GHF/grits/Grits 1.2a.pdf

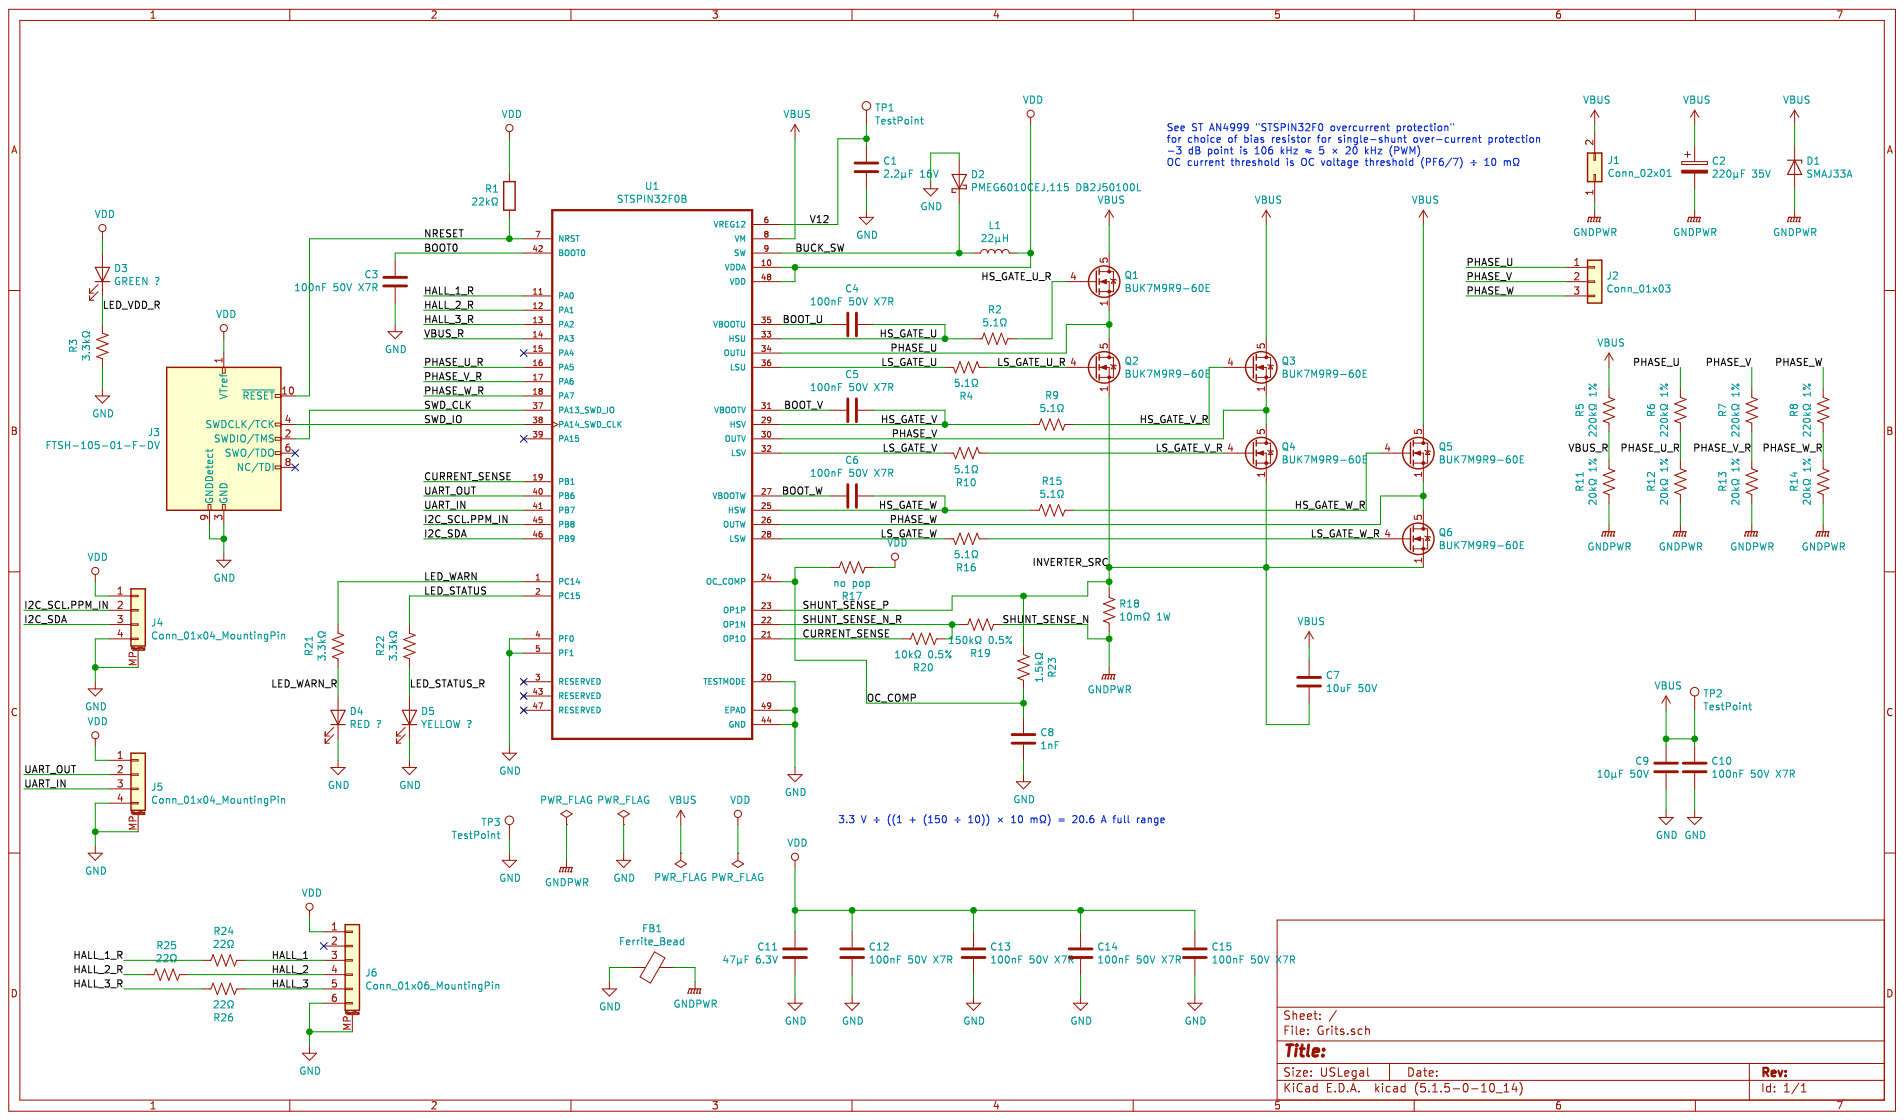
[picture p1: page 1]
