GHF/grits/Grits 1.2b.pdf

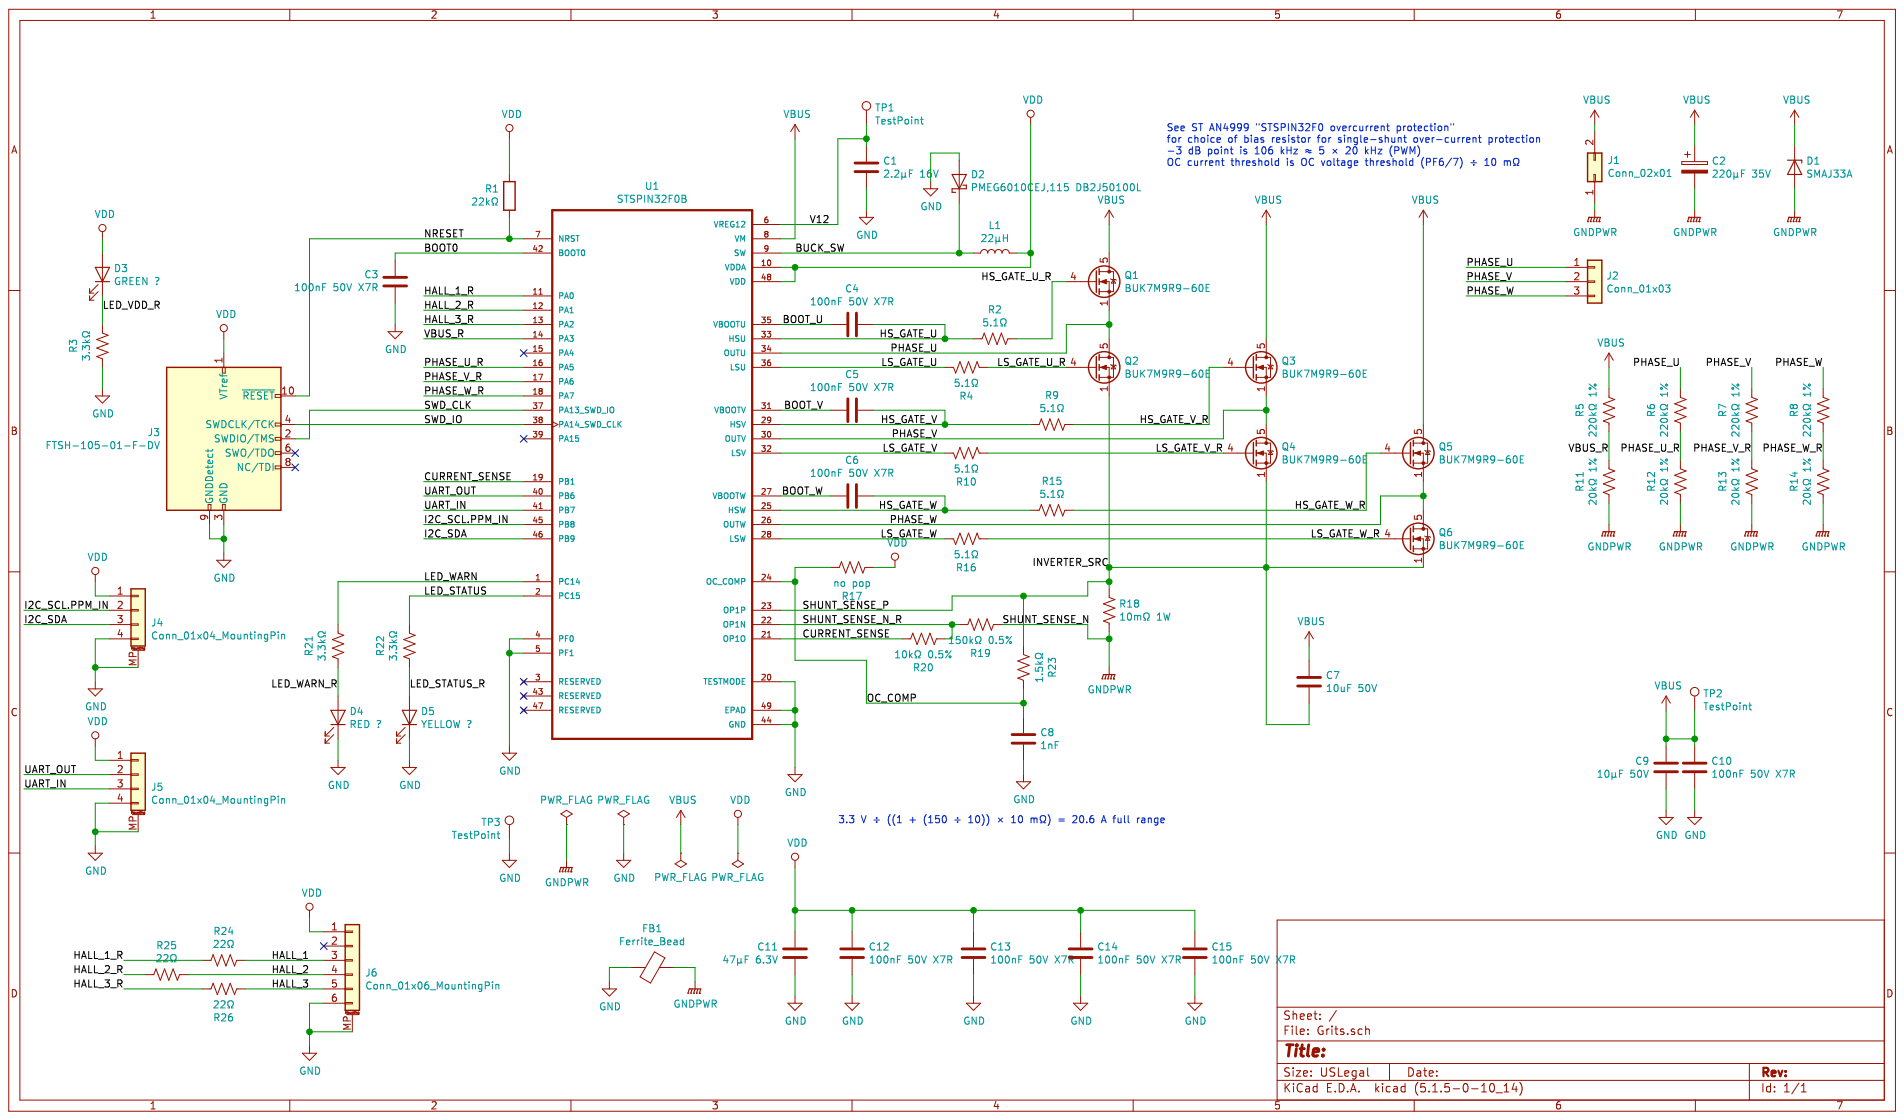
[picture p2: page 1]
