GHF/grits/Grits v1.3a.pdf

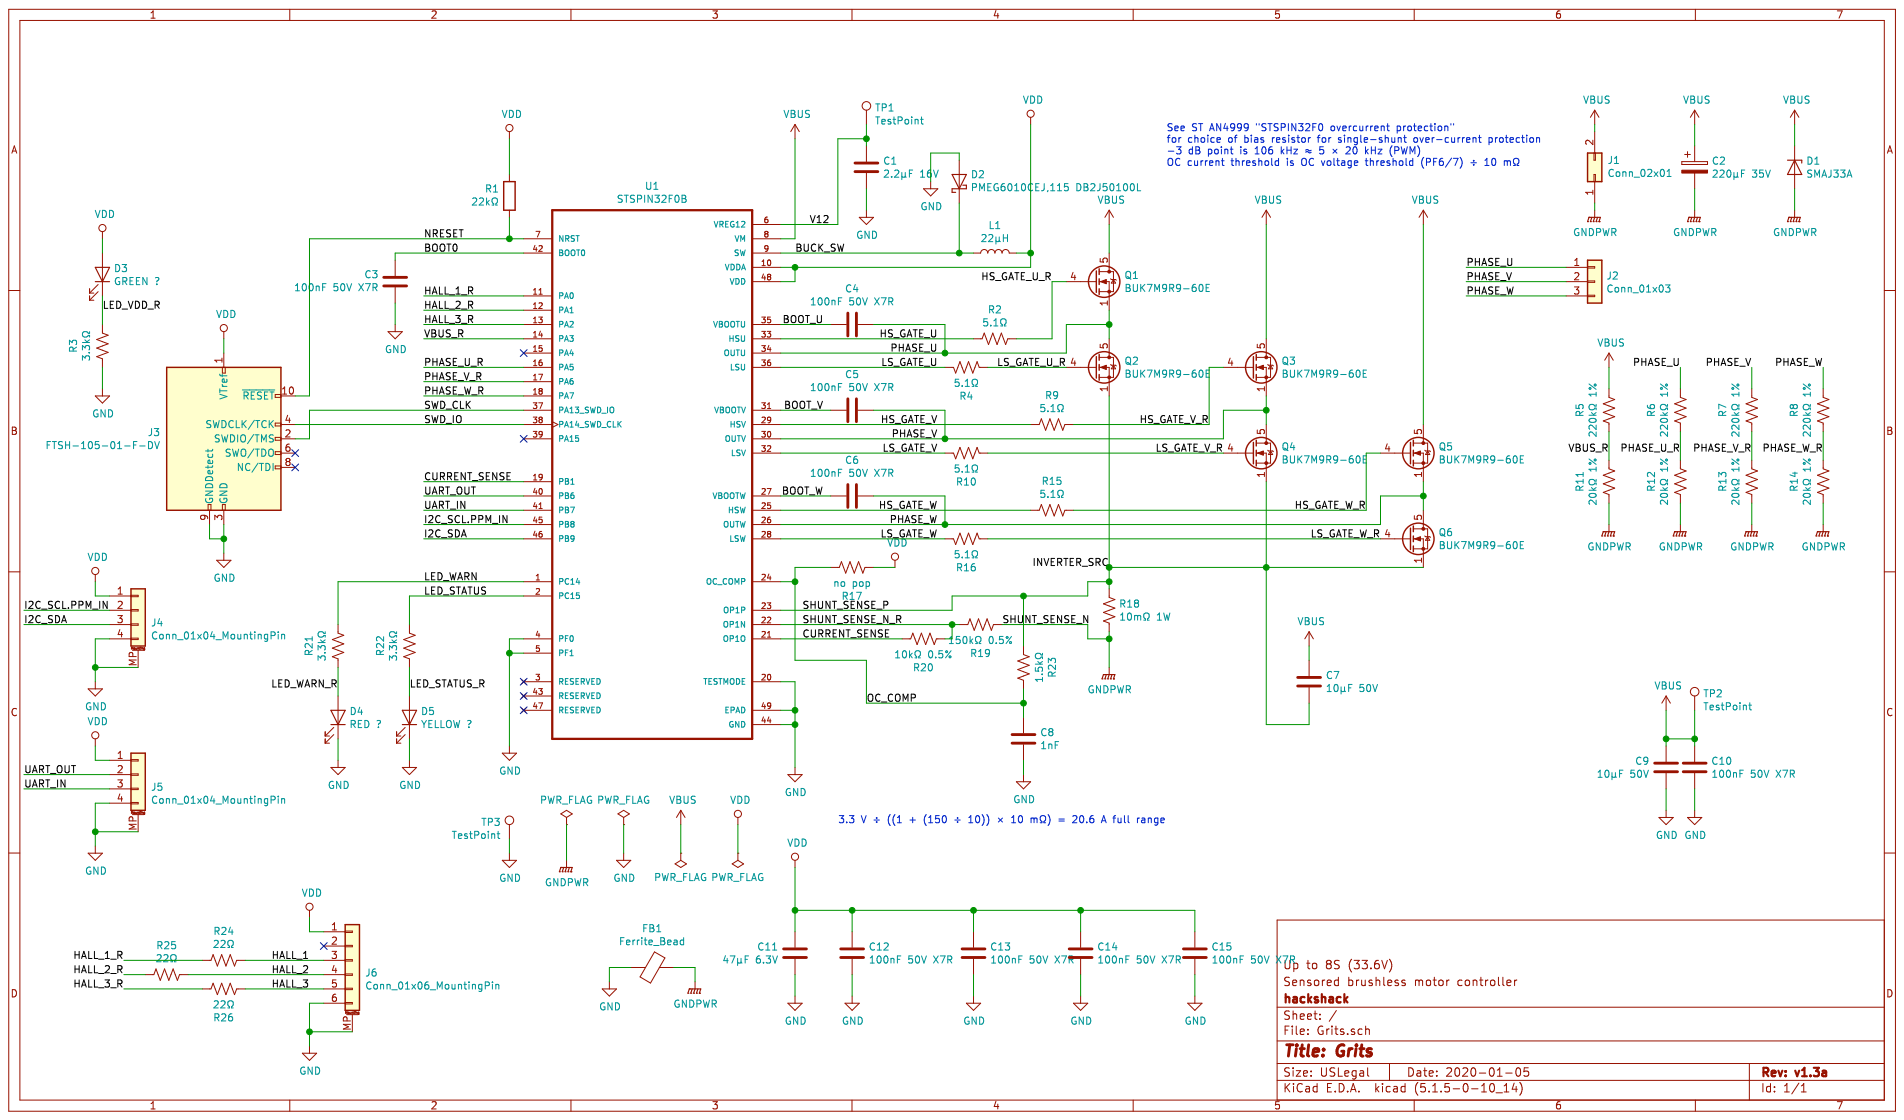
[picture p3: page 1]
