GHF/grits/Grits.kicad_pcb

## KiCad design Grits.kicad_pcb (2020-01-05)

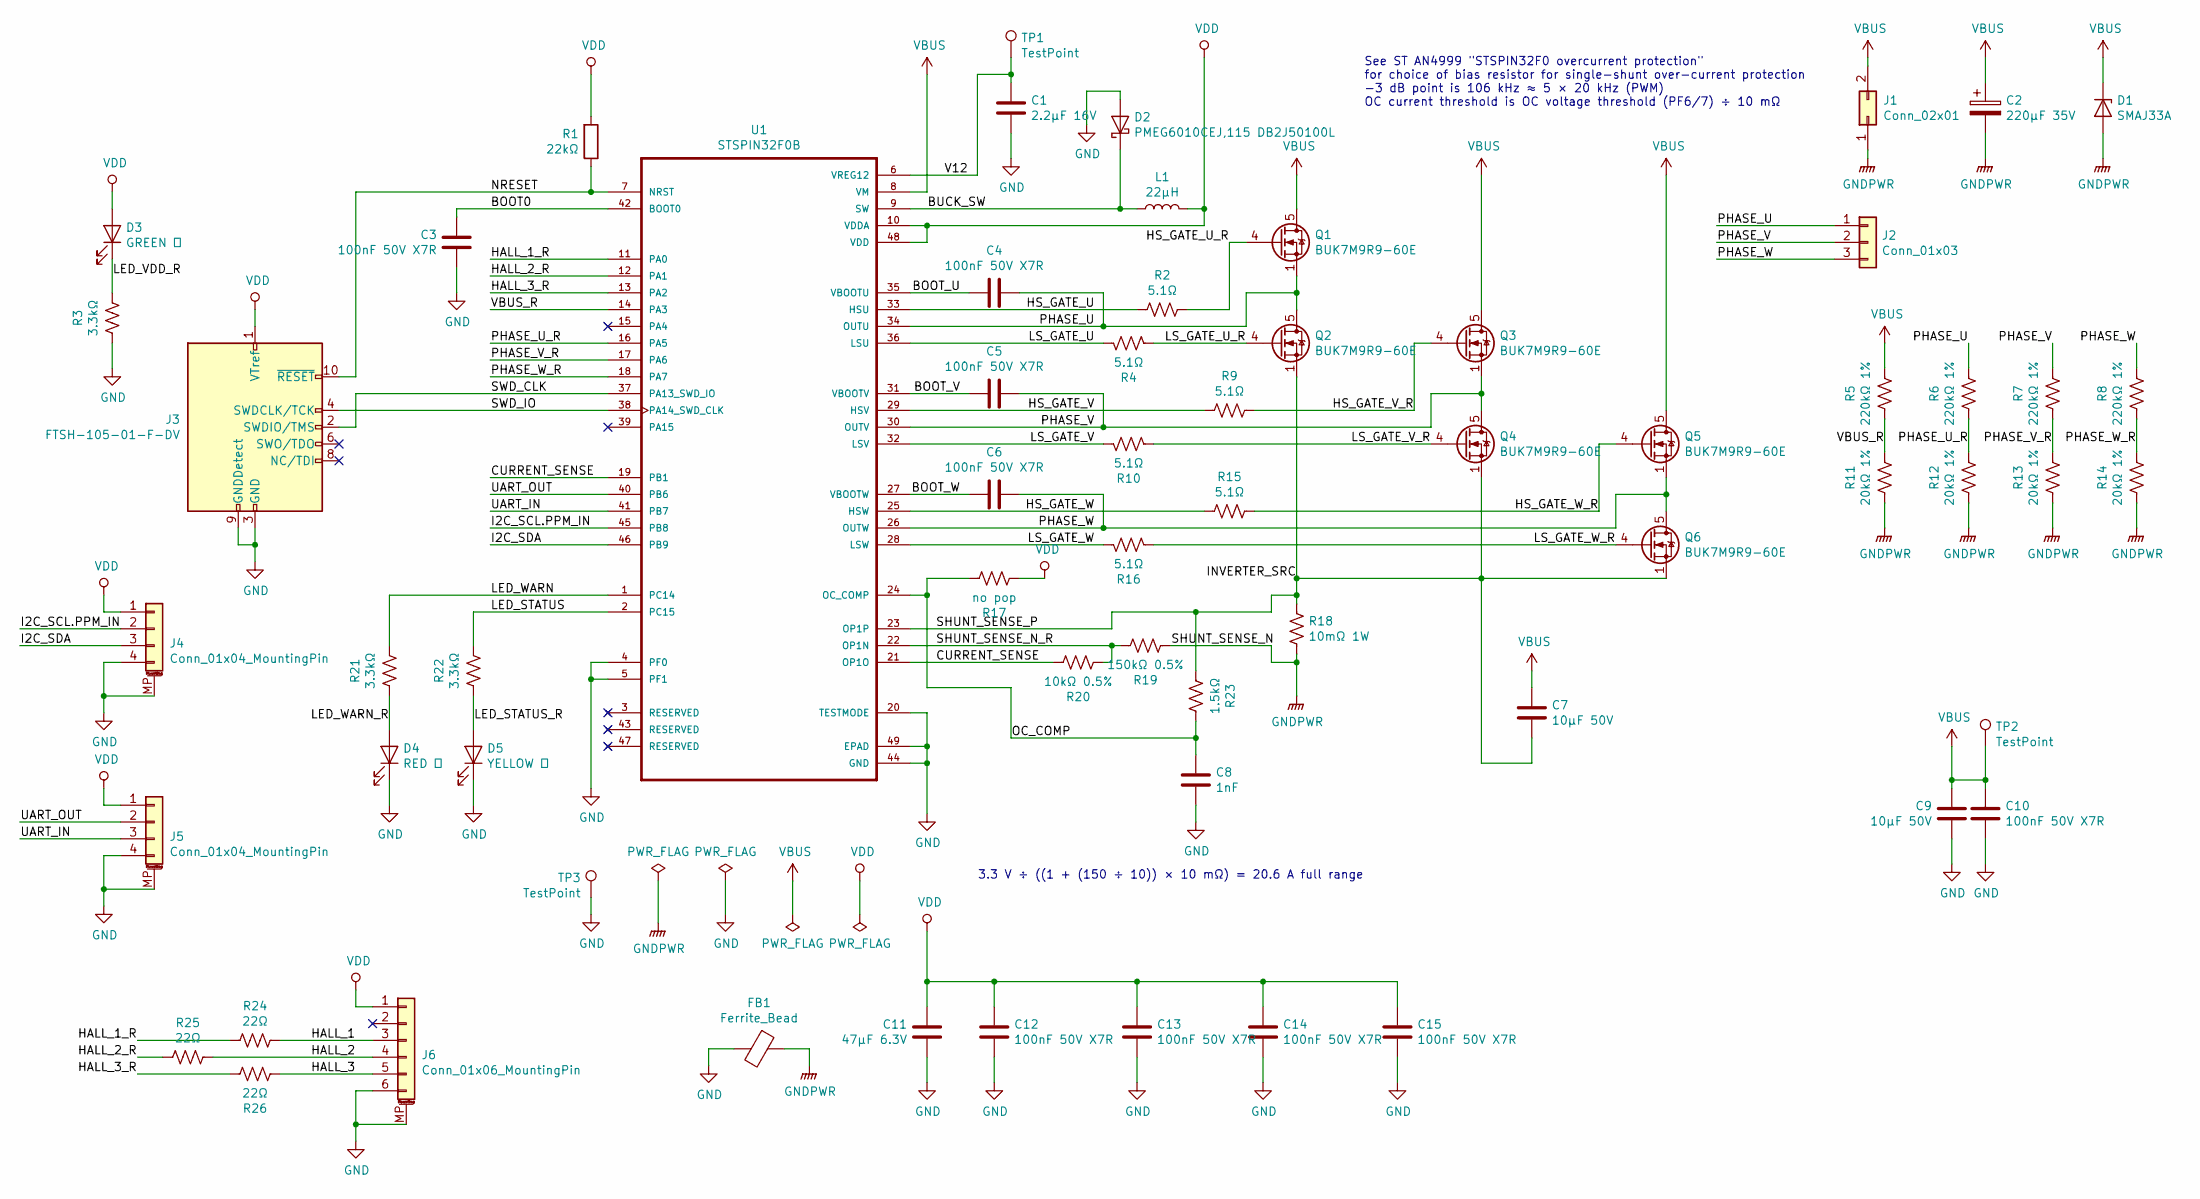
[picture p4: schematic Grits.sch]

Parts:
C1: 2.2µF 16V; C_0603_1608Metric
C2: 220µF 35V; CP_Elec_8x10.5
C3, C4, C5, C6, C10, C12, C13, C14, C15: 100nF 50V X7R; C_0603_1608Metric
C7, C9: 10µF 50V; C_1206_3216Metric
C8: 1nF; C_0603_1608Metric
C11: 47µF 6.3V; C_0805_2012Metric
D1: SMAJ33A; D_SMA
D2: PMEG6010CEJ,115 DB2J50100L; D_SOD-323F
D3: GREEN 绿; LED_0805_2012Metric
D4: RED 红; LED_0805_2012Metric
D5: YELLOW 黄; LED_0805_2012Metric
FB1: Ferrite_Bead; L_0603_1608Metric
J1: Conn_02x01; Molex_Micro-Fit_3.0_43045-0200_2x01_P3.00mm_Horizontal
J2: Conn_01x03; Molex_Micro-Fit_3.0_43650-0300_1x03_P3.00mm_Horizontal
J3: FTSH-105-01-F-DV; PinHeader_2x05_P1.27mm_Vertical_SMD
J4, J5: Conn_01x04_MountingPin; JST_GH_SM04B-GHS-TB_1x04-1MP_P1.25mm_Horizontal
J6: Conn_01x06_MountingPin; JST_GH_BM06B-GHS-TBT_1x06-1MP_P1.25mm_Vertical
L1: 22µH; L_1008_2520Metric
Q1, Q2, Q3, Q4, Q5, Q6: BUK7M9R9-60E; LFPAK33
R1: 22kΩ; R_0603_1608Metric
R2, R4, R9, R10, R15, R16: 5.1Ω; R_0603_1608Metric
R3, R21, R22: 3.3kΩ; R_0603_1608Metric
R5, R6, R7, R8: 220kΩ 1%; R_0603_1608Metric
R11, R12, R13, R14: 20kΩ 1%; R_0603_1608Metric
R17: no pop; R_0603_1608Metric
R18: 10mΩ 1W; R_1206_3216Metric
R19: 150kΩ 0.5%; R_0603_1608Metric
R20: 10kΩ 0.5%; R_0603_1608Metric
R23: 1.5kΩ; R_0603_1608Metric
R24, R25, R26: 22Ω; R_0603_1608Metric
TP1, TP2, TP3: TestPoint; TestPoint_Pad_D1.0mm
U1: STSPIN32F0B; VQFN-48-1EP_7x7mm_P0.5mm_EP2.8x2.8mm

Connections:
/BOOT0: C3.2, U1.42 (BOOT0)
/BOOT_U: C4.2, U1.35 (VBOOTU)
/BOOT_V: C5.2, U1.31 (VBOOTV)
/BOOT_W: C6.2, U1.27 (VBOOTW)
/BUCK_SW: D2.1 (K), L1.1, U1.9 (SW)
/CURRENT_SENSE: R20.1, U1.19 (PB1), U1.21 (OP1O)
/HALL_1: J6.3, R24.1
/HALL_1_R: R24.2, U1.11 (PA0)
/HALL_2: J6.4, R25.1
/HALL_2_R: R25.2, U1.12 (PA1)
/HALL_3: J6.5, R26.2
/HALL_3_R: R26.1, U1.13 (PA2)
/HS_GATE_U: R2.2, U1.33 (HSU)
/HS_GATE_U_R: Q1.4 (G), R2.1
/HS_GATE_V: R9.2, U1.29 (HSV)
/HS_GATE_V_R: Q3.4 (G), R9.1
/HS_GATE_W: R15.2, U1.25 (HSW)
/HS_GATE_W_R: Q5.4 (G), R15.1
/I2C_SCL.PPM_IN: J4.2, U1.45 (PB8)
/I2C_SDA: J4.3, U1.46 (PB9)
/INVERTER_SRC: C7.2, Q2.1 (S), Q2.2 (S), Q2.3 (S), Q4.1 (S), Q4.2 (S), Q4.3 (S), Q6.1 (S), Q6.2 (S), Q6.3 (S), R18.1, R23.2, U1.23 (OP1P)
/LED_STATUS: R22.1, U1.2 (PC15)
/LED_STATUS_R: D5.2 (A), R22.2
/LED_VDD_R: D3.1 (K), R3.1
/LED_WARN: R21.1, U1.1 (PC14)
/LED_WARN_R: D4.2 (A), R21.2
/LS_GATE_U: R4.2, U1.36 (LSU)
/LS_GATE_U_R: Q2.4 (G), R4.1
/LS_GATE_V: R10.2, U1.32 (LSV)
/LS_GATE_V_R: Q4.4 (G), R10.1
/LS_GATE_W: R16.2, U1.28 (LSW)
/LS_GATE_W_R: Q6.4 (G), R16.1
/NRESET: J3.10 (~RESET~), R1.1, U1.7 (NRST)
/OC_COMP: C8.1, R17.1, R23.1, U1.24 (OC_COMP)
/PHASE_U: C4.1, J2.1, Q1.1 (S), Q1.2 (S), Q1.3 (S), Q2.5 (D), R6.1, U1.34 (OUTU)
/PHASE_U_R: R6.2, R12.1, U1.16 (PA5)
/PHASE_V: C5.1, J2.2, Q3.1 (S), Q3.2 (S), Q3.3 (S), Q4.5 (D), R7.1, U1.30 (OUTV)
/PHASE_V_R: R7.2, R13.1, U1.17 (PA6)
/PHASE_W: C6.1, J2.3, Q5.1 (S), Q5.2 (S), Q5.3 (S), Q6.5 (D), R8.1, U1.26 (OUTW)
/PHASE_W_R: R8.2, R14.1, U1.18 (PA7)
/SHUNT_SENSE_N_R: R19.1, R20.2, U1.22 (OP1N)
/SWD_CLK: J3.2 (SWDIO/TMS), U1.37 (PA13_SWD_IO)
/SWD_IO: J3.4 (SWDCLK/TCK), U1.38 (PA14_SWD_CLK)
/UART_IN: J5.3, U1.41 (PB7)
/UART_OUT: J5.2, U1.40 (PB6)
/V12: C1.1, TP1.1, U1.6 (VREG12)
/VBUS_R: R5.2, R11.1, U1.14 (PA3)
GND: C1.2, C3.1, C8.2, C9.2, C10.2, C11.2, C12.2, C13.2, C14.2, C15.2, D2.2 (A), D4.1 (K), D5.1 (K), FB1.2, J3.3 (GND), J3.5 (GND), J3.9 (GNDDetect), J4.4, J4.MP (MountPin), J5.4, J5.MP (MountPin), J6.6, J6.MP (MountPin), R3.2, TP3.1, U1.4 (PF0), U1.5 (PF1), U1.20 (TESTMODE), U1.44 (GND), U1.49 (EPAD)
GNDPWR: C2.2, D1.2 (A), FB1.1, J1.1, R11.2, R12.2, R13.2, R14.2, R18.2, R19.2
VBUS: C2.1, C7.1, C9.1, C10.1, D1.1 (K), J1.2, Q1.5 (D), Q3.5 (D), Q5.5 (D), R5.1, TP2.1, U1.8 (VM)
VDD: C11.1, C12.1, C13.1, C14.1, C15.1, D3.2 (A), J3.1 (VTref), J4.1, J5.1, J6.1, L1.2, R1.2, R17.2, U1.10 (VDDA), U1.48 (VDD)

Notes on the sheet:
See ST AN4999 "STSPIN32F0 overcurrent protection" for choice of bias resistor for single-shunt over-current protection -3 dB point is 106 kHz ≈ 5 × 20 kHz (PWM) OC current threshold is OC voltage threshold (PF6/7) ÷ 10 mΩ
3.3 V ÷ ((1 + (150 ÷ 10)) × 10 mΩ) = 20.6 A full range

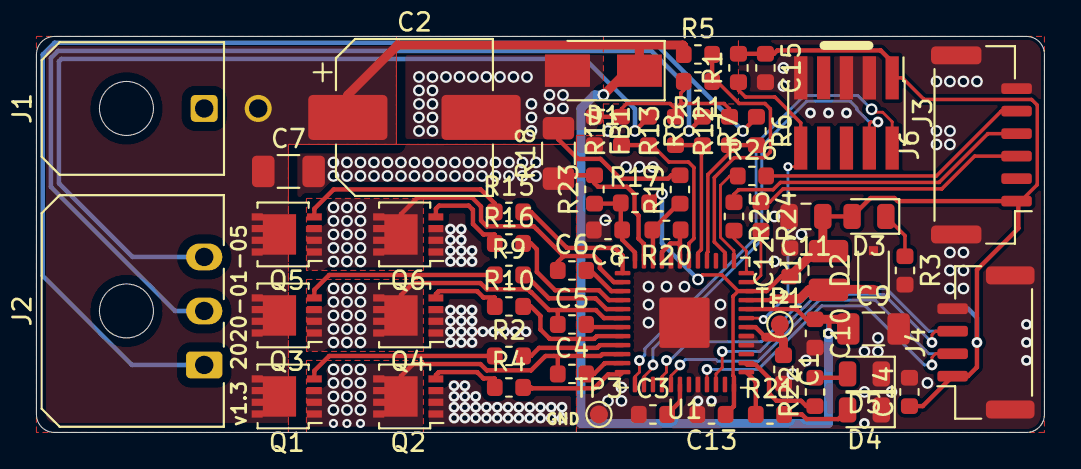
[picture p5: board Grits.kicad_pcb from above]

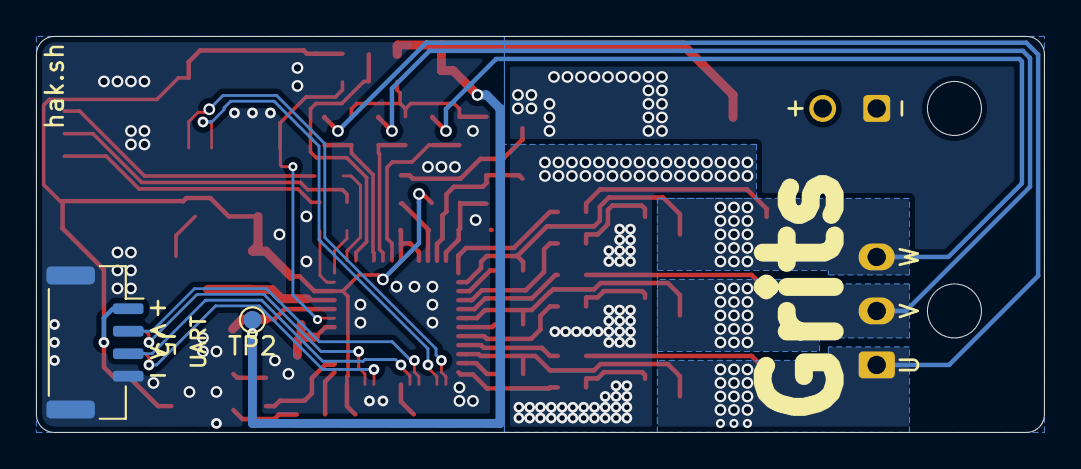
[picture p6: board Grits.kicad_pcb from below]

Board: 2 copper layers, 56.0 x 22.0 mm, 64 parts (2 on the bottom side), 51 nets.
