GHF/grits/(commit log)

2020-01-04 ✨ Add v1.0c
    [Grits.kicad_pcb, Grits.sch]
2020-01-04 ♻️ Clean up rev A and B
2020-01-04 ✨ Add v1.1
    Featuring rotated Hall connector going to different timer inputs
    [Grits-B_Cu.gbr, Grits-B_Mask.gbr, Grits-B_Paste.gbr, Grits-B_SilkS.gbr, Grits-Edge_Cuts.gbr, Grits-F_Cu.gbr, Grits-F_Mask.gbr, Grits-F_Paste.gbr]
2020-01-05 ✨ Add v1.3a (DFM)
    v1.2: Retooled for DFM through JLCPCB
    v1.3: Fix bootstrap capacitor wiring error
    [Grits-B_Cu.gbr, Grits-B_Mask.gbr, Grits-B_Paste.gbr, Grits-B_SilkS.gbr, Grits-Edge_Cuts.gbr, Grits-F_Cu.gbr, Grits-F_Mask.gbr, Grits-F_Paste.gbr]
